pedrovfr/CapSense/CapSense_python/dummy.png

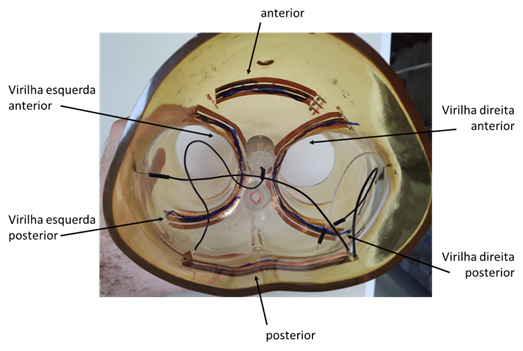
CapSense_python/dummy.png
