pedrovfr/CapSense/README.md

# CapSense
Capacitive Sense project repo
This project is formed by a python script in the folder CapSense_python, by a MCU firmware in the folder Firmware and by the PCB files in the folder capSense_board
