pedrovfr/CapSense/CapSense_python/legenda_software.png

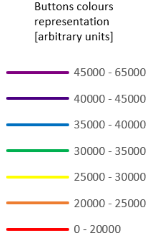
CapSense_python/legenda_software.png
