pedrovfr/CapSense/BOM.xlsx

Computador single board | Raspberry pi 4 | https://www.digikey.com/product-detail/en/raspberry-pi/RASPBERRY-PI-4B-2GB/1690-RASPBERRYPI4B-2GB-ND/10258782
microcontrolador | EFM8SB1 | https://www.digikey.com/product-detail/en/silicon-labs/EFM8SB10F8G-A-QFN24/336-3173-5-ND/5115730
Regulador | LF33CV | https://www.digikey.com/product-detail/en/stmicroelectronics/LF33CV/497-7313-5-ND/1038546
Capacitor | 10u
 | 10u | http://componentsearchengine.com/Datasheets/1/CC0603KRX7R7BB104.pdf
 | 100n
 | 100n | http://componentsearchengine.com/Datasheets/1/CC0603KRX7R7BB104.pdf
Resistor | 1k | http://www.vishay.com/docs/28724/mrs16m25.pdf
 | 1k
 | 1k
LED baixa potência | verde | https://www.cree.com/led-components/media/documents/C503B-RAS-RAN-AAS-AAN-RBS-RBN-ABS-ABN-RCS-RCN-ACS-ACN-1079.pdf
 | vermelho
Conector blindado | RJ45 | https://www.te.com/commerce/DocumentDelivery/DDEController?Action=srchrtrv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
Cabo | RJ45
Gravador debugger | C2 | https://www.digikey.com/products/en?keywords=Silicon%20Labs%20DEBUGADPTR1-USB
Placa de desenvolvimento | SLSTK2011A (chip EFM8SB) | https://www.silabs.com/development-tools/mcu/8-bit/slstk2011a-efm8sb2-starter-kit
 | SLEXP8008A (chip cpt112s) | https://www.silabs.com/development-tools/interface/cpt112s-development-kit
 | SLEXP8007A (chip cpt007b) | https://www.silabs.com/development-tools/interface/cpt007b-development-kit
 | FDC1004EVM | https://www.ti.com/tool/FDC1004EVM
 | FDC2214EVM | https://www.ti.com/tool/FDC2214EVM?keyMatch=FDC2214&tisearch=Search-EN-everything&usecase=GPN
Fita de cobre | 5mm width
