pedrovfr/CapSense/CapSense_interface_board/BOM.xls

Comment | Description | Designator | Footprint | LibRef | Quantity
EFM8SB10F8G-A-QFN24 | 8-bit Microcontrollers - MCU Laser Bee Microcontroller IC 8-Bit 72MHz 64KB 24-QFN | B1 | *QFN50P400X400X80-25N | EFM8SB1x-QFN24 | 1
EFM8SB10F2G-A-QFN20 | Silicon Labs EFM8SB10F2G-A-QFN20, 8bit CIP-51 Microcontroller, 25MHz, 2 kB Flash, 20-Pin QFN | B2 | EFM8SB10F8GAQFN20R | EFM8SB10F2G-A-QFN20 | 1
10u | TAJ SMT tant capacitor,Case C,25V,10uF AVX 10uF SMD Solid MnO2 Tantalum Electrolytic Capacitor, 25 V dc +/-10%, TAJ Series | C1, C3 | CAPPM6032X280N | Tantalum capacitor | 2
100n | CAPACITOR, 0603 100nF +/-10% 16V | C2, C4 | CAPC1608X90N | CC0603KRX7R7BB104 | 2
Header 6 | Header, 6-Pin | P1, P2, P3, P4 | HDR1X6 | Header 6 | 4
Header 5 | Header, 5-Pin | P5, P6, P7, P8 | HDR1X5 | Header 5 | 4
