pedrovfr/CapSense/(list of files, cad)

Other CAD files:
Firmware/Keil 8051 v9.53 - Debug/src/main.OBJ
Firmware/Keil 8051 v9.53 - Debug/src/InitDevice.OBJ
Firmware/Keil 8051 v9.53 - Debug/src/Interrupts.OBJ
Firmware/Keil 8051 v9.53 - Debug/src/SILABS_STARTUP.OBJ
