pedrovfr/CapSense/(list of files, drawings)

Other design files:
CapSense_interface_board/mcu_capsense_adapter.PcbDoc
CapSense_interface_board/mcu_capsense_adapter.PrjPcb
CapSense_interface_board/mcu_capsense_adapter.SchDoc
capSense_interface_board_MCU_adapter/capSense_interface_board_MCU_adapter.PcbDoc
capSense_interface_board_MCU_adapter/capSense_interface_board_MCU_adapter.PrjPcb
capSense_interface_board_MCU_adapter/capSense_interface_board_MCU_adapter.SchDoc
