pedrovfr/CapSense/(commit log)

2021-07-15 Capacitive Sense master thesis project
    [BOM.xls, capSense_interface_board_MCU_adapter.PcbDoc, capSense_interface_board_MCU_adapter.PrjPcb, capSense_interface_board_MCU_adapter.SchDoc, mcu_capsense_adapter.PcbDoc, mcu_capsense_adapter.PrjPcb, mcu_capsense_adapter.SchDoc]
2021-07-15 Firmware files
    [InitDevice.OBJ, Interrupts.OBJ, SILABS_STARTUP.OBJ, main.OBJ]
2021-07-15 Bill of materials
    [BOM.xlsx]
2021-07-15 PCB files of the MCU adapter to the interface board
2021-07-15 PCB files of the MCUadapter to the interface board
2021-07-15 PCB files of MCU adapter to the interface board
    [capSense_interface_board_MCU_adapter.PcbDoc, capSense_interface_board_MCU_adapter.PrjPcb, capSense_interface_board_MCU_adapter.SchDoc]
2021-07-15 PCB files of the interface board
    [BOM.xls, mcu_capsense_adapter.PcbDoc, mcu_capsense_adapter.PrjPcb, mcu_capsense_adapter.SchDoc]
